gnanendarreddypalagiri/EDL_project/MON-14/Layout_MON-14/Layout_BOTTOM_MON-14.pdf

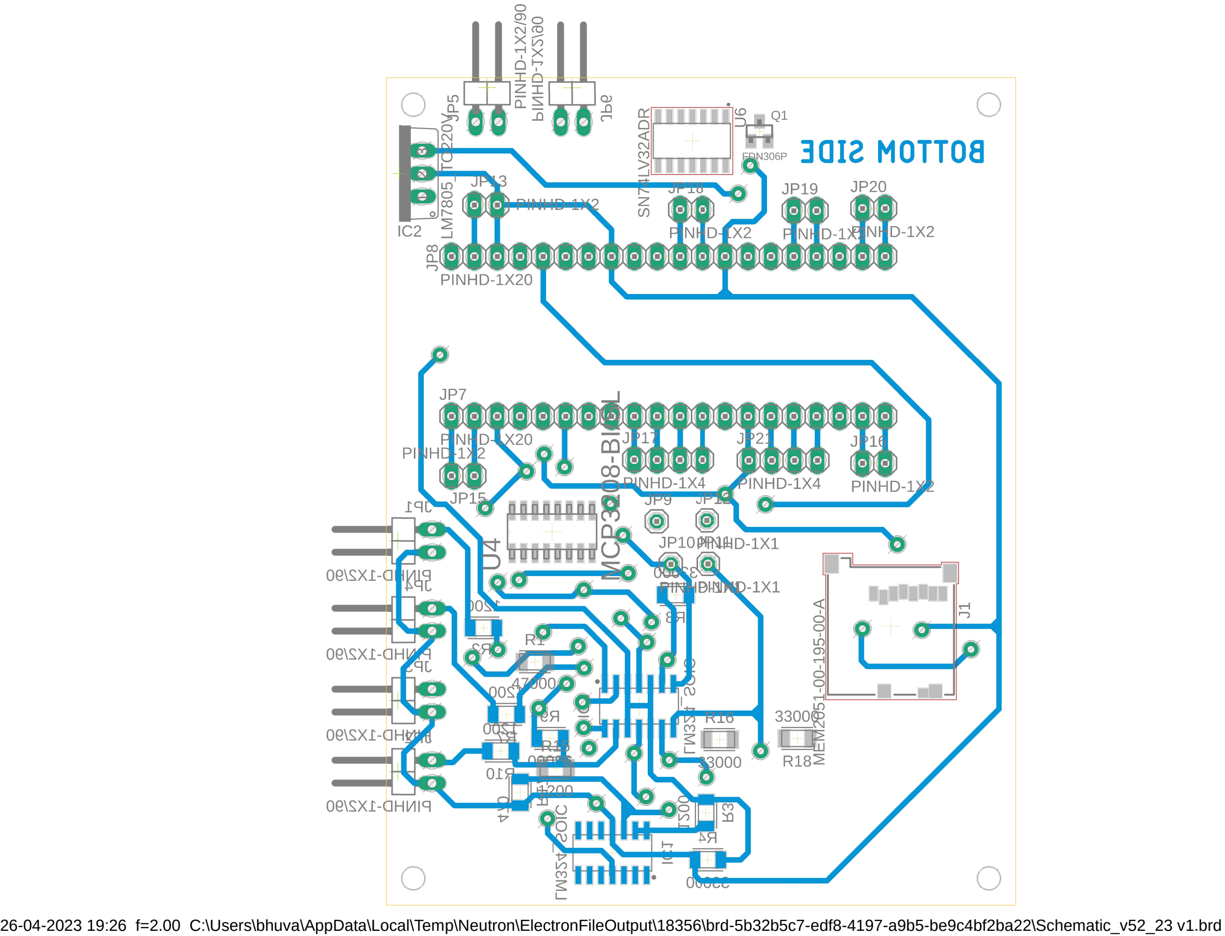
[picture p10: page 1]

26-04-2023 19:26 f=2.00 C:\Users\bhuva\AppData\Local\Temp\Neutron\ElectronFileOutput\18356\brd-5b32b5c7-edf8-4197-a9b5-be9c4bf2ba22\Schematic_v52_23 v1.brd LM³²⁴_SOIC

IC2
