gnanendarreddypalagiri/EDL_project/MON-14/CAD_DXF_FILES_MON-14/CAD_3D_MON-14.png

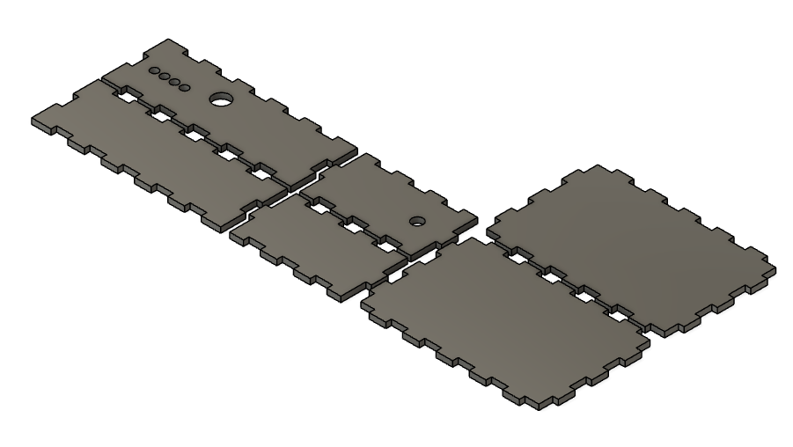
MON-14/CAD_DXF_FILES_MON-14/CAD_3D_MON-14.png
