gnanendarreddypalagiri/EDL_project/MON-14/Layout_MON-14/Layout_BOTTOM_MON-14.png

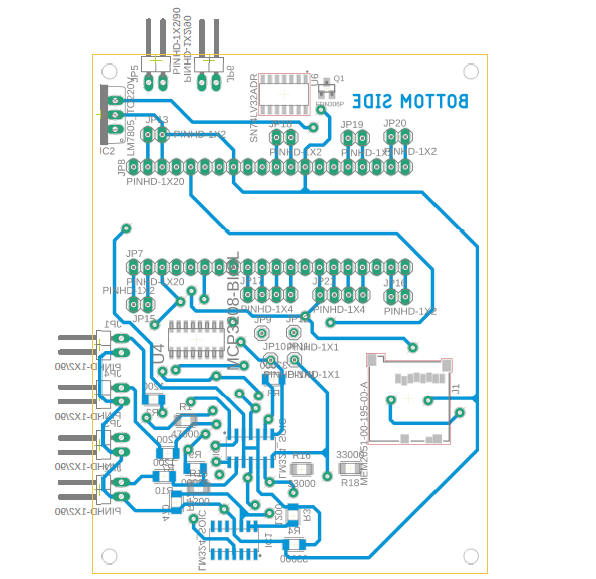
MON-14/Layout_MON-14/Layout_BOTTOM_MON-14.png
