gnanendarreddypalagiri/EDL_project/MON-14/Schematic_MON-14/Schematic_MON-14.png

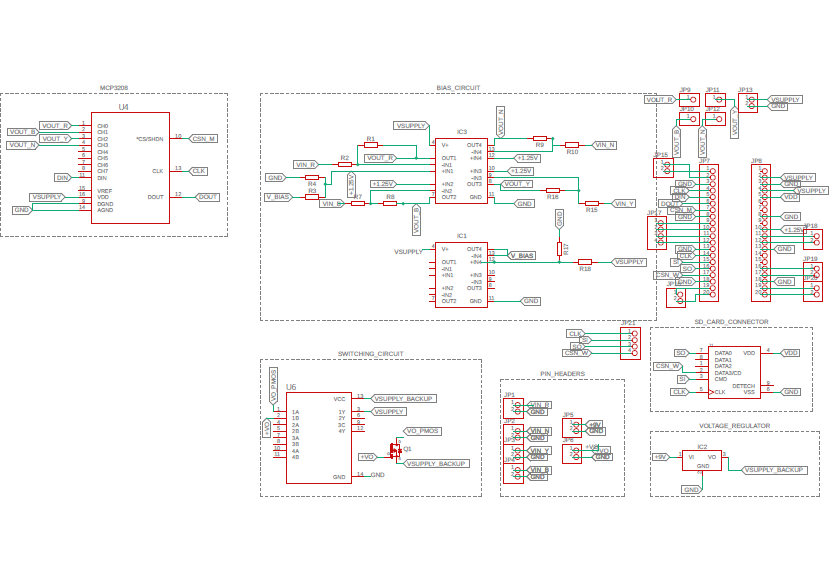
MON-14/Schematic_MON-14/Schematic_MON-14.png
