gnanendarreddypalagiri/EDL_project/MON-14/CAD_DXF_FILES_MON-14/face2.dxf

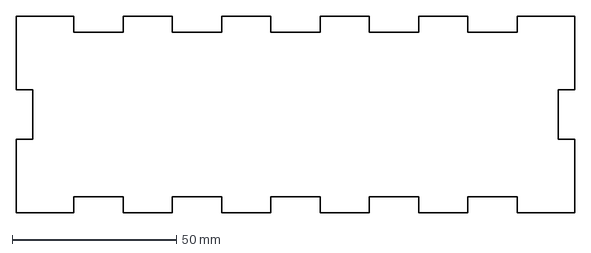
[picture p16: CAD file, 2023-08-18]
MON-14/CAD_DXF_FILES_MON-14/face2.dxf
170.0 x 60.0 mm
