gnanendarreddypalagiri/EDL_project/MON-14/CAD_DXF_FILES_MON-14/face4.dxf

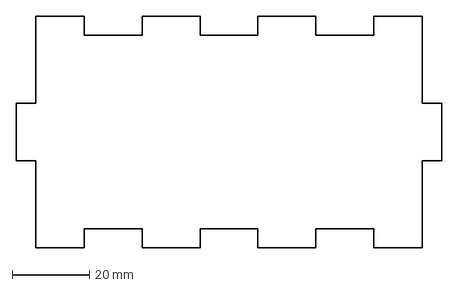
[picture p17: CAD file, 2023-08-18]
MON-14/CAD_DXF_FILES_MON-14/face4.dxf
110.0 x 60.0 mm
