gnanendarreddypalagiri/EDL_project/MON-14/CAD_DXF_FILES_MON-14/face5.dxf

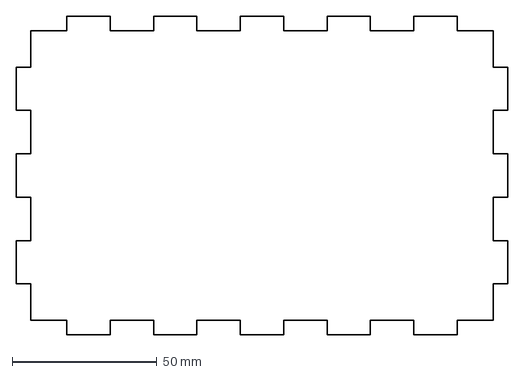
[picture p18: CAD file, 2023-08-18]
MON-14/CAD_DXF_FILES_MON-14/face5.dxf
170.0 x 110.0 mm
