gnanendarreddypalagiri/EDL_project/MON-14/CAD_DXF_FILES_MON-14/face3.dxf

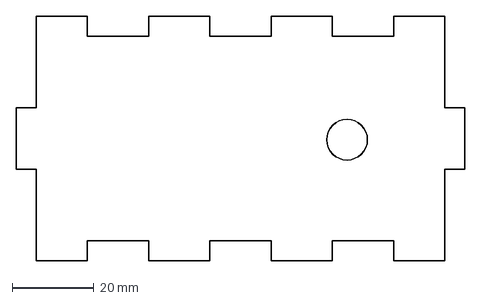
[picture p19: CAD file, 2023-08-18]
MON-14/CAD_DXF_FILES_MON-14/face3.dxf
110.0 x 60.0 mm
