gnanendarreddypalagiri/EDL_project/MON-14/CAD_DXF_FILES_MON-14/face6.dxf

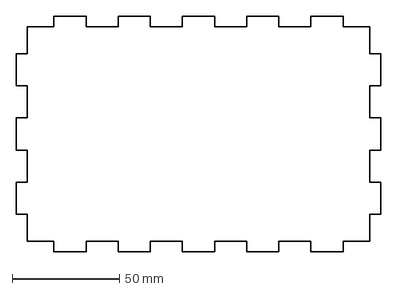
[picture p20: CAD file, 2023-08-18]
MON-14/CAD_DXF_FILES_MON-14/face6.dxf
170.0 x 110.0 mm
