gnanendarreddypalagiri/EDL_project/MON-14/Schematic_MON-14/Schematic_MON-14.pdf

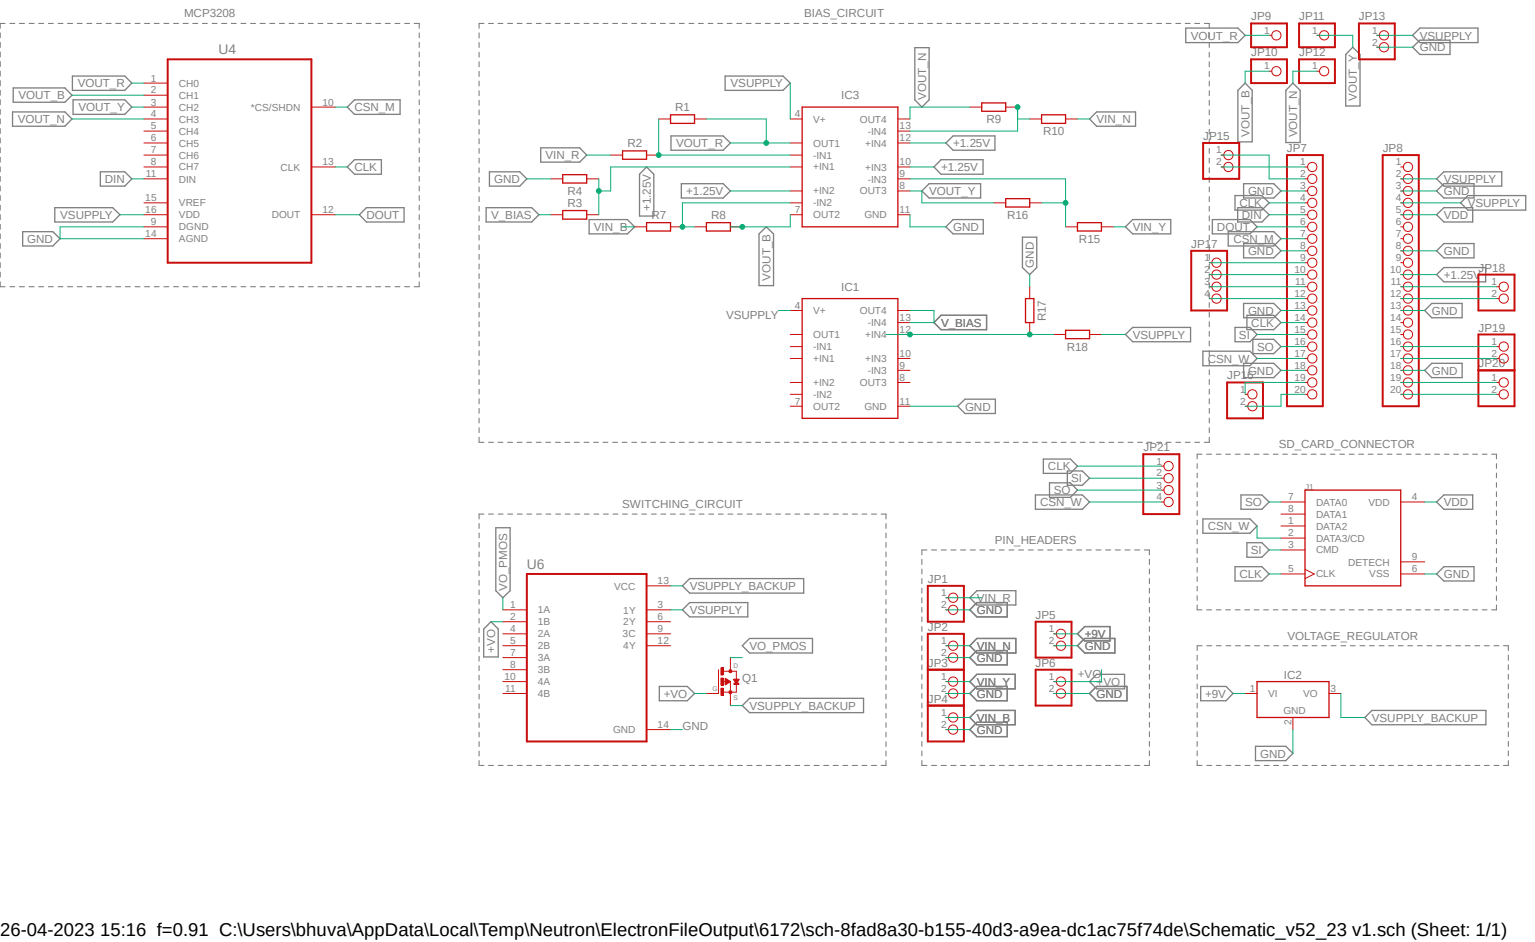
[picture p22: page 1]

26-04-2023 15:16 f=0.91 C:\Users\bhuva\AppData\Local\Temp\Neutron\ElectronFileOutput\6172\sch-8fad8a30-b155-40d3-a9ea-dc1ac75f74de\Schematic_v52_23 v1.sch (Sheet: 1/1)
