gnanendarreddypalagiri/EDL_project/MON-14/Layout_MON-14/Layout_MON-14.brd

## EAGLE design MON-14/Layout_MON-14/Layout_MON-14.brd (2023-08-18)

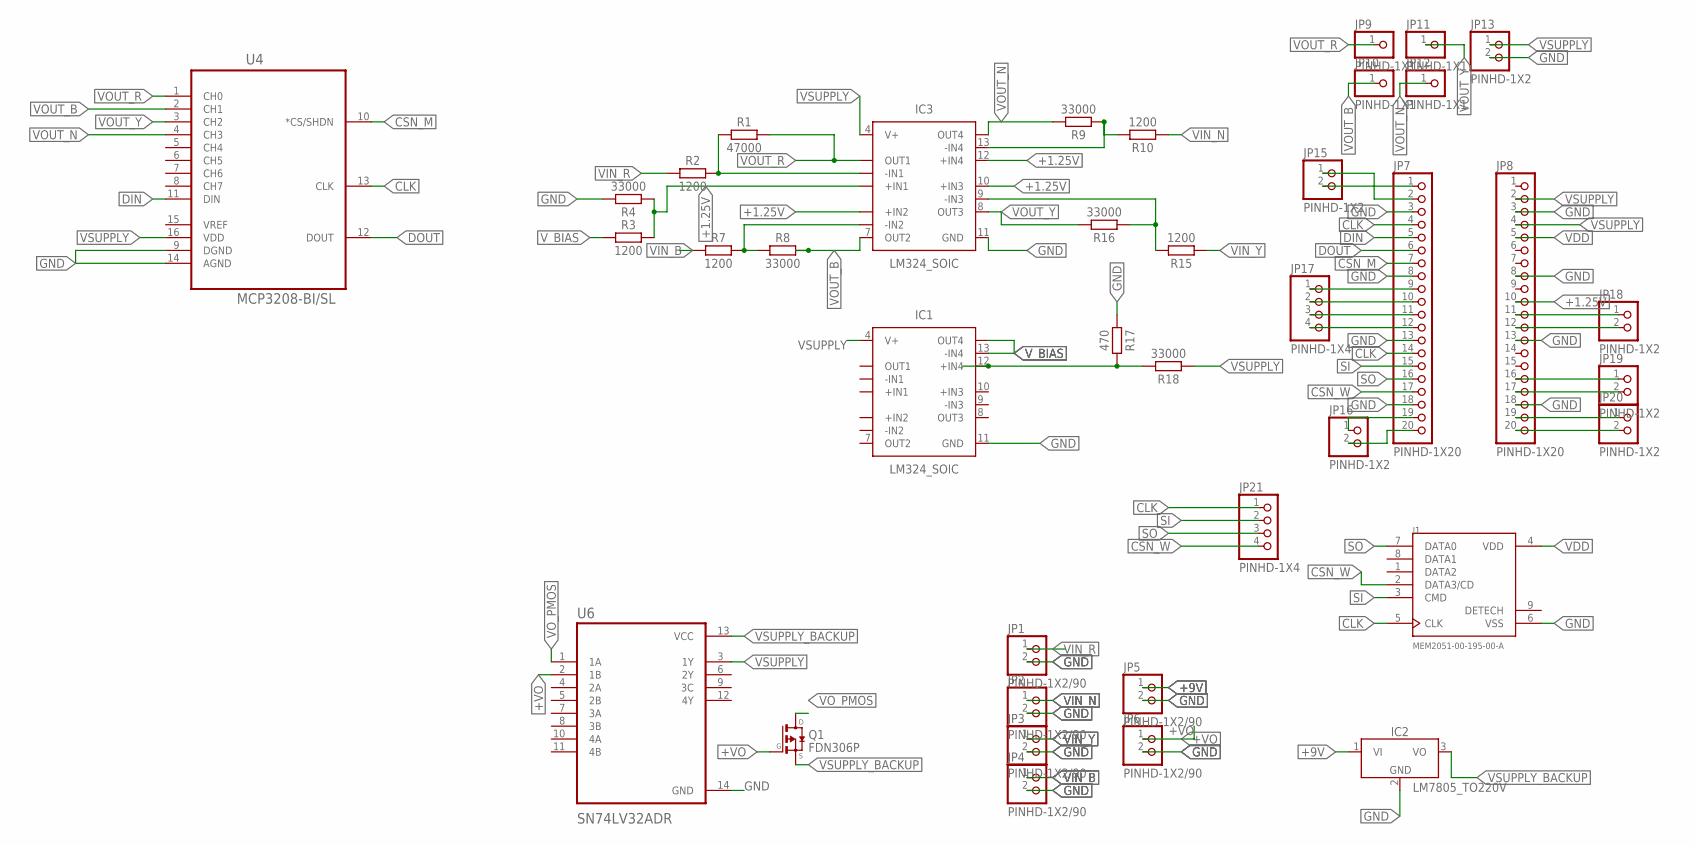
[picture p23: schematic Schematic_MON-14.sch]

Parts:
IC1, IC3: LM324_SOIC; SOIC127P600X175-14N
IC2: LM7805_TO220V; TO220V
J1: MEM2051-00-195-00-A; GCT_MEM2051-00-195-00-A
JP1, JP2, JP3, JP4, JP5, JP6: PINHD-1X2/90; 1X02/90
JP7, JP8: PINHD-1X20; 1X20
JP9, JP10, JP11, JP12: PINHD-1X1; 1X01
JP13, JP15, JP16, JP18, JP19, JP20: PINHD-1X2; 1X02
JP17, JP21: PINHD-1X4; 1X04
Q1: FDN306P; SSOT-3
R1: 47000; RESC3216X70
R2, R3, R7, R10, R15: 1200; RESC3216X70
R4, R8, R9, R16, R18: 33000; RESC3216X70
R17: 470; RESC3216X70
U4: MCP3208-BI/SL; SOIC127P600X175-16N
U6: SN74LV32ADR; SOIC127P600X175-14N

Connections:
+1.25V: IC3.3 (+IN1), IC3.5 (+IN2), IC3.10 (+IN3), IC3.12 (+IN4), JP8.10, R3.2, R4.1
+9V: IC2.1 (VI), JP5.1
+VO: JP6.1, Q1.1 (G), U6.2 (1B)
CLK: J1.5 (CLK), JP7.4, JP7.14, JP21.1, U4.13 (CLK)
CSN_M: JP7.7, U4.10 (*CS/SHDN)
CSN_W: J1.2 (DATA3/CD), JP7.17, JP21.4
DIN: JP7.5, U4.11 (DIN)
DOUT: JP7.6, U4.12 (DOUT)
GND: IC1.11 (GND), IC2.2 (GND), IC3.11 (GND), J1.6 (VSS), JP1.2, JP2.2, JP3.2, JP4.2, JP5.2, JP6.2, JP7.3, JP7.8, JP7.13, JP7.18, JP8.3, JP8.8, JP8.13, JP8.18, JP13.2, R4.2, R17.1, U4.9 (DGND), U4.14 (AGND), U6.14 (GND)
unnamed: JP8.20, JP20.2
unnamed: JP8.19, JP20.1
unnamed: JP8.17, JP19.2
unnamed: IC3.6 (-IN2), R7.2, R8.1
unnamed: IC3.9 (-IN3), R15.2, R16.1
unnamed: JP8.16, JP19.1
unnamed: JP7.9, JP17.1
unnamed: IC3.2 (-IN1), R1.1, R2.2
unnamed: IC3.13 (-IN4), R9.1, R10.2
unnamed: JP7.10, JP17.2
unnamed: JP7.11, JP17.3
unnamed: JP7.12, JP17.4
unnamed: IC1.12 (+IN4), R17.2, R18.2
unnamed: JP7.19, JP16.1
unnamed: JP7.20, JP16.2
unnamed: JP7.1, JP15.2
unnamed: JP7.2, JP15.1
unnamed: JP8.11, JP18.1
unnamed: JP8.12, JP18.2
SI: J1.3 (CMD), JP7.15, JP21.2
SO: J1.7 (DATA0), JP7.16, JP21.3
VDD: J1.4 (VDD), JP8.5
VIN_B: JP4.1, R7.1
VIN_N: JP2.1, R10.1
VIN_R: JP1.1, R2.1
VIN_Y: JP3.1, R15.1
VOUT_B: IC3.7 (OUT2), JP10.1, R8.2, U4.2 (CH1)
VOUT_N: IC3.14 (OUT4), JP12.1, R9.2, U4.4 (CH3)
VOUT_R: IC3.1 (OUT1), JP9.1, R1.2, U4.1 (CH0)
VOUT_Y: IC3.8 (OUT3), JP11.1, R16.2, U4.3 (CH2)
VO_PMOS: Q1.3 (D), U6.1 (1A)
VSUPPLY: IC1.4 (V+), IC3.4 (V+), JP8.2, JP8.4, JP13.1, R18.1, U4.16 (VDD), U6.3 (1Y)
VSUPPLY_BACKUP: IC2.3 (VO), Q1.2 (S), U6.13 (VCC)
V_BIAS: IC1.13 (-IN4), IC1.14 (OUT4), R3.1

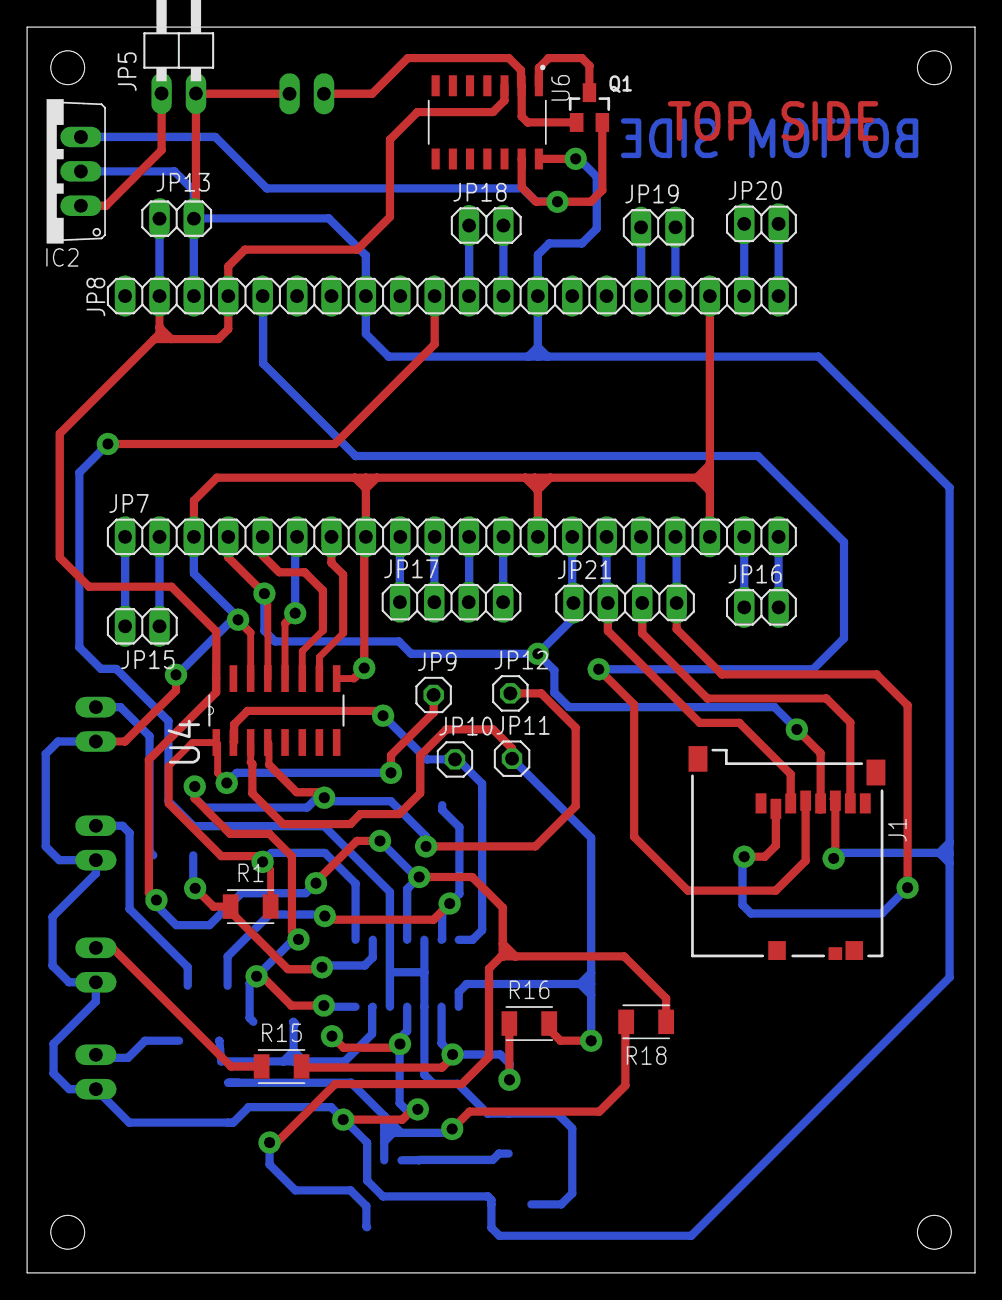
[picture p24: board Layout_MON-14.brd from above]

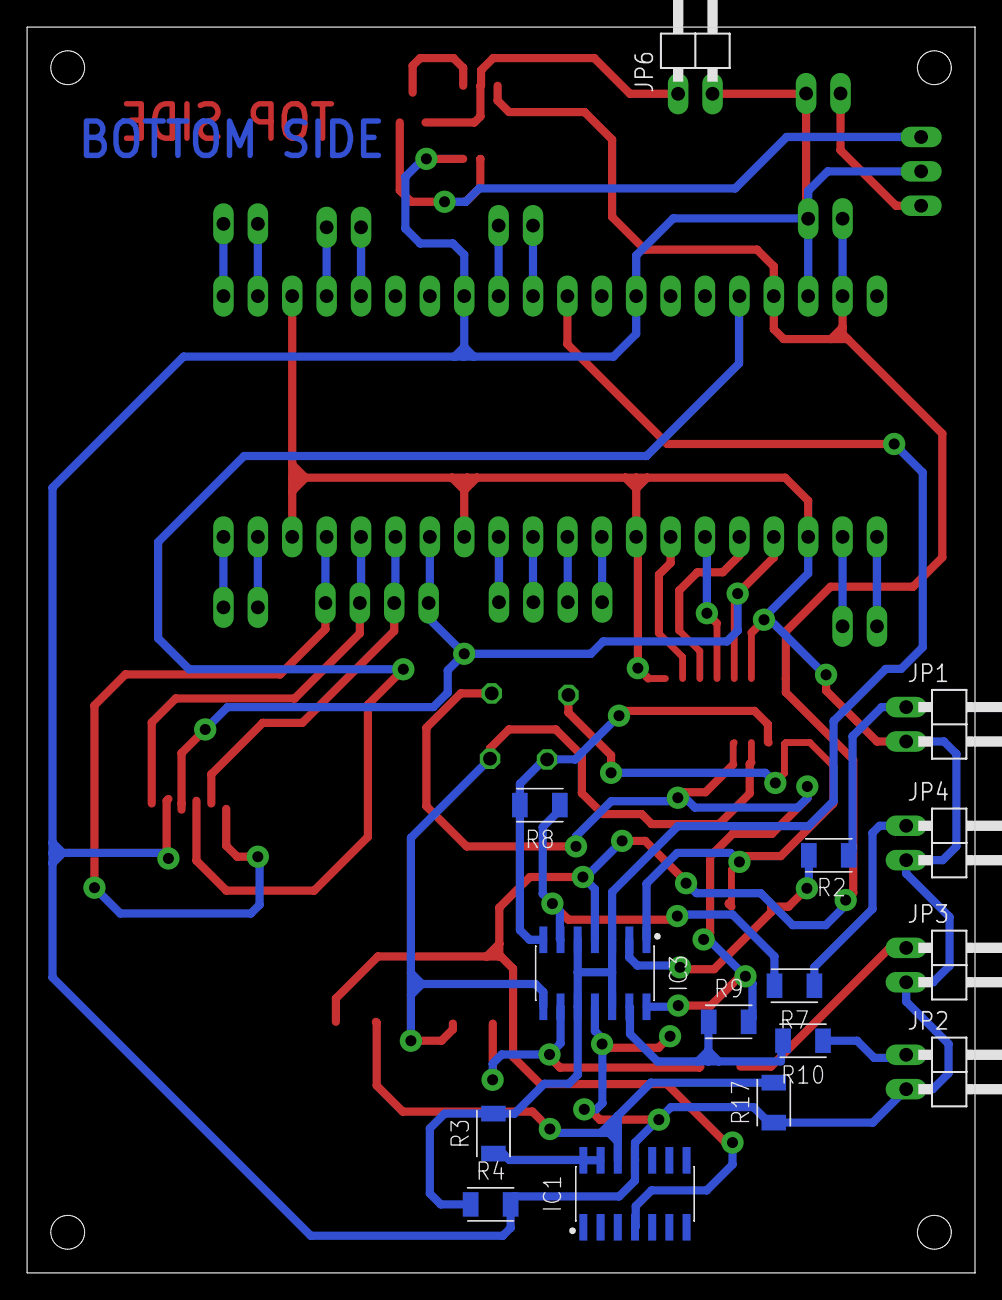
[picture p25: board Layout_MON-14.brd from below]

Board: 2 copper layers, 70.0 x 92.0 mm, 39 parts (15 on the bottom side), 43 nets.
